valerian736/MYTHRILL-SOC/DE10-NANO/src/MLP_include.sv

`define numLayers 4
`define dataWidth 32

`define numNeuronLayer1 4
`define numWeightLayer1 5
`define Layer1ActType "relu"

`define numNeuronLayer2 4
`define numWeightLayer2 4
`define Layer2ActType "relu"

`define numNeuronLayer3 1
`define numWeightLayer3 4
`define Layer3ActType "linear"

`define weightIntWidth 16

`define fuckyou 1
