valerian736/MYTHRILL-SOC/(commit log)

2026-10-08 rtl repository for chip competition
    [c5_pin_model_dump.txt]
2026-10-09 add back output files
    [device.cfg]
2026-10-12 Expand application scope of MYTHRILL-SOC
    Added potential applications for MYTHRILL-SOC beyond USV thruster control.
